gmcastil/6502-sbc/doc/README.md

Schematics here - not necessarily synced with the current board design.
