gmcastil/6502-sbc/doc/schematics/SBC-prototype.pdf

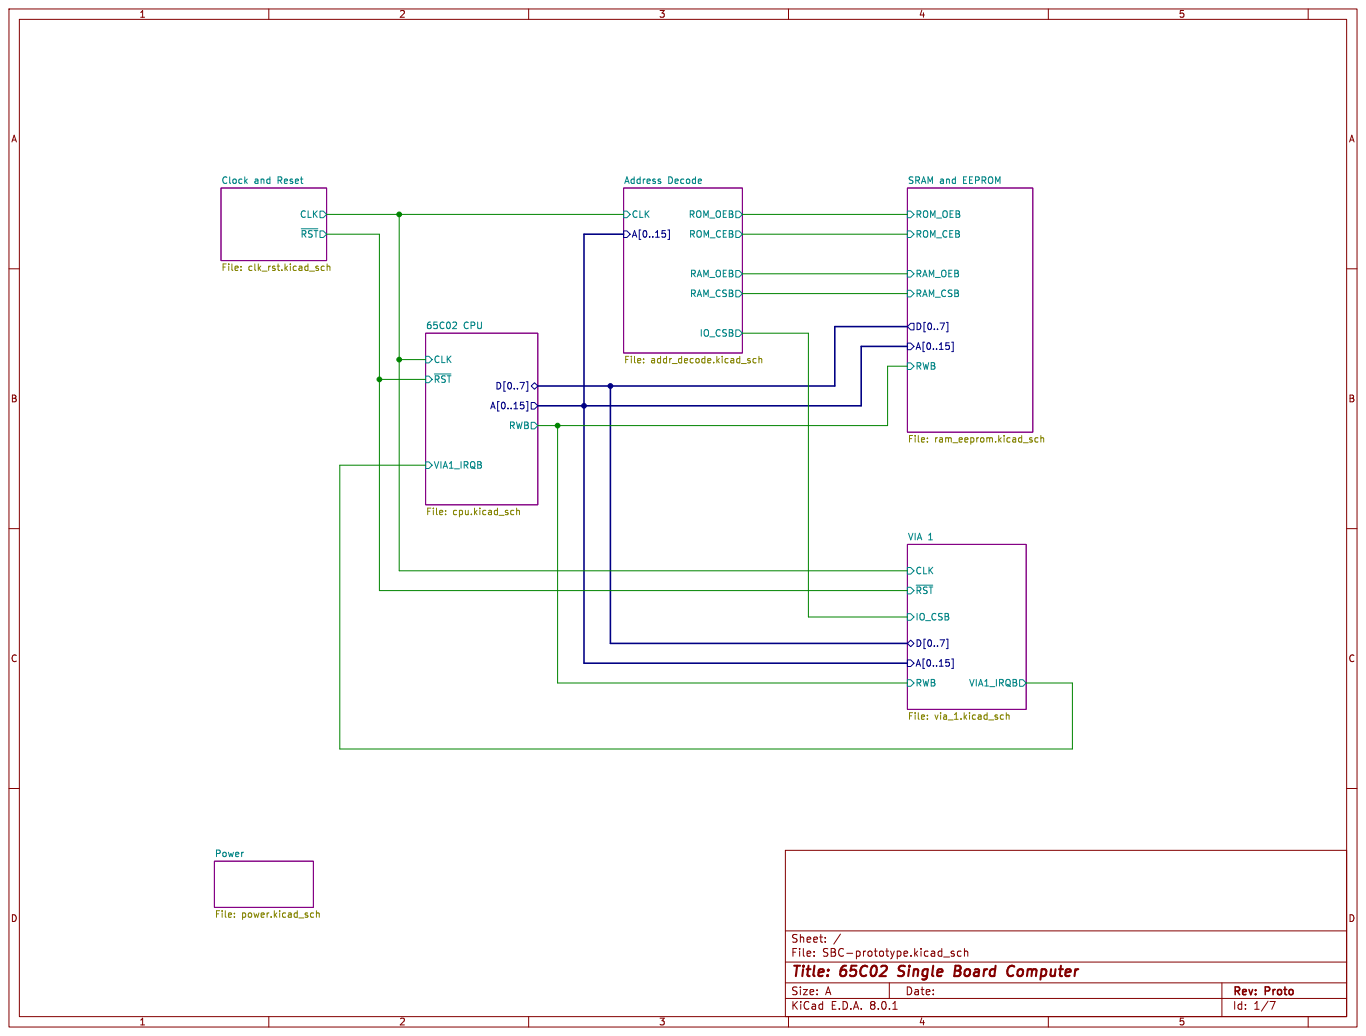
[picture p1: page 1]

~{RST} Clock and Reset File: clk_rst.kicad_sch Power File: power.kicad_sch

Id: 1/7 Title: 65C02 Single Board Computer File: SBC-prototype.kicad_sch Sheet: /

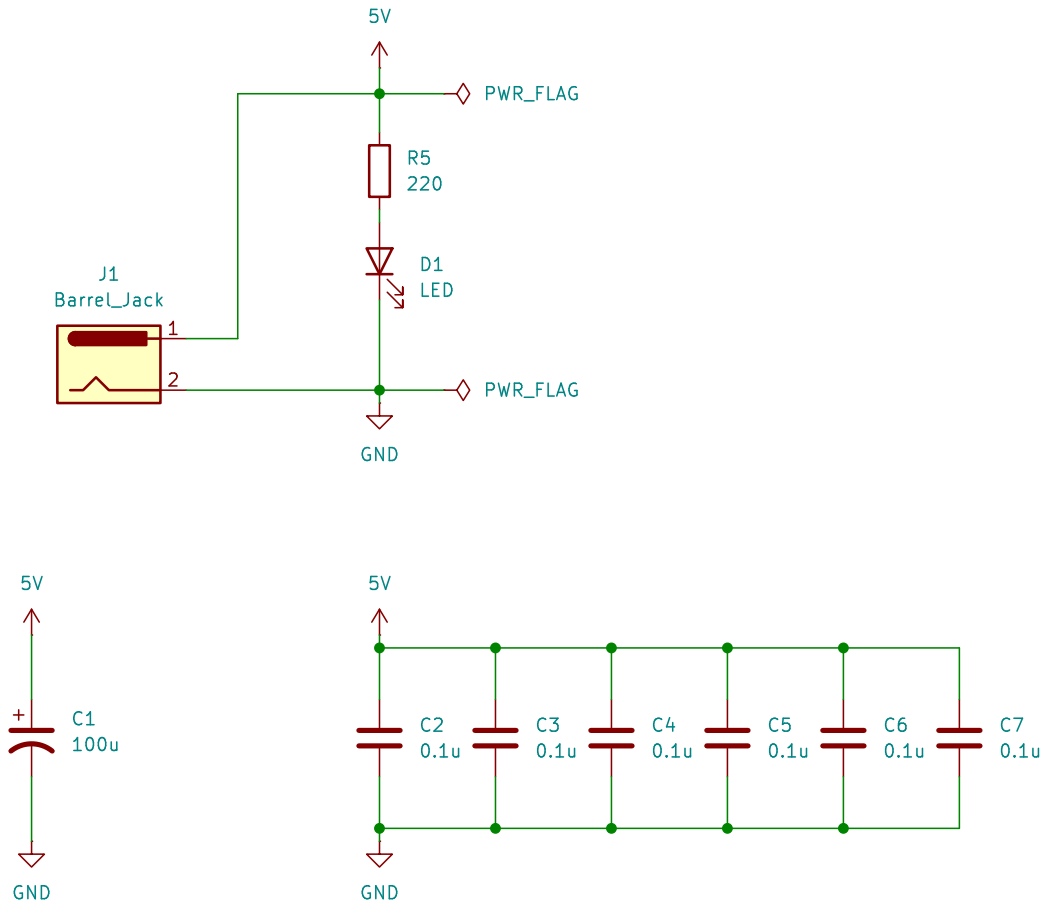
[picture p2: page 2]

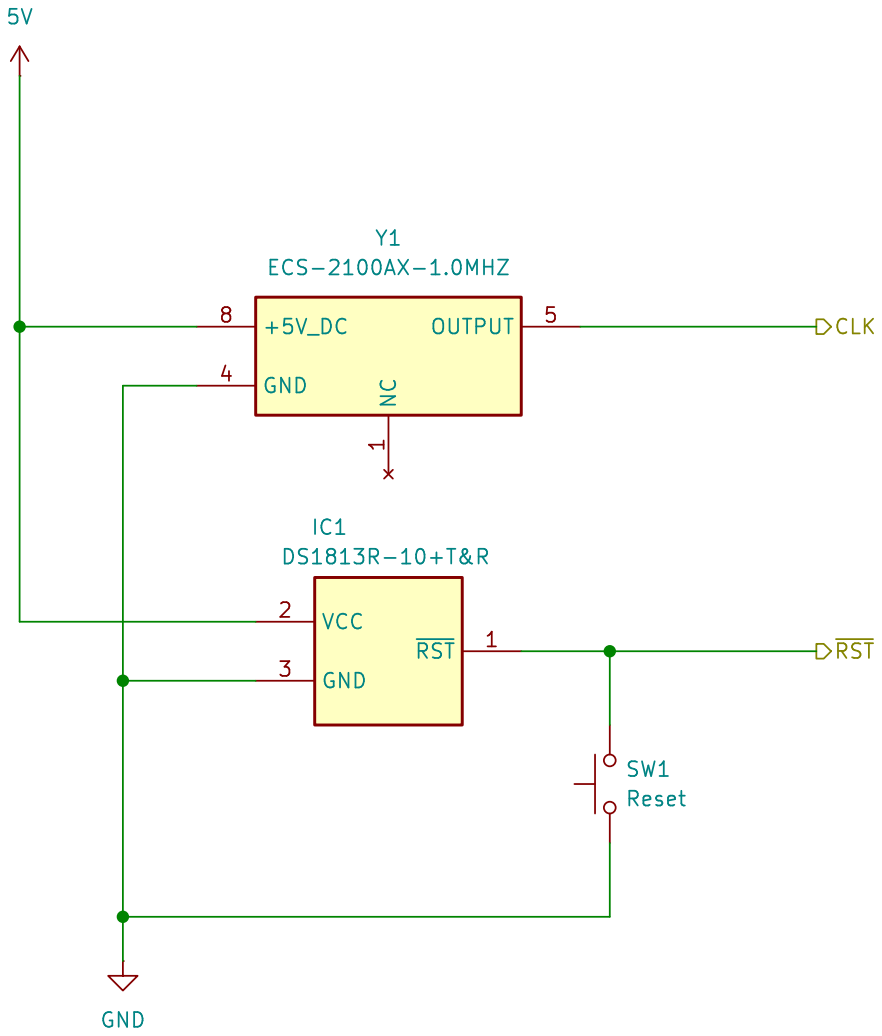
[picture p3: page 3]

1 GND 4 OUTPUT 5 +5V_DC 8 Y1 ECS-2100AX-1.0MHZ CLK

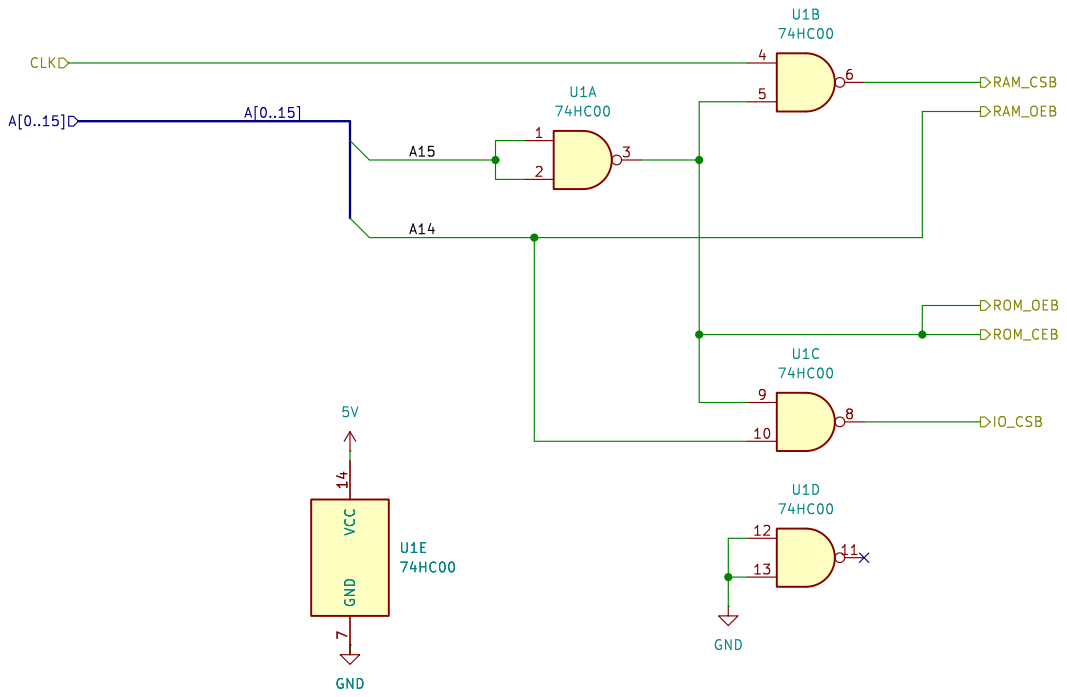
[picture p4: page 4]

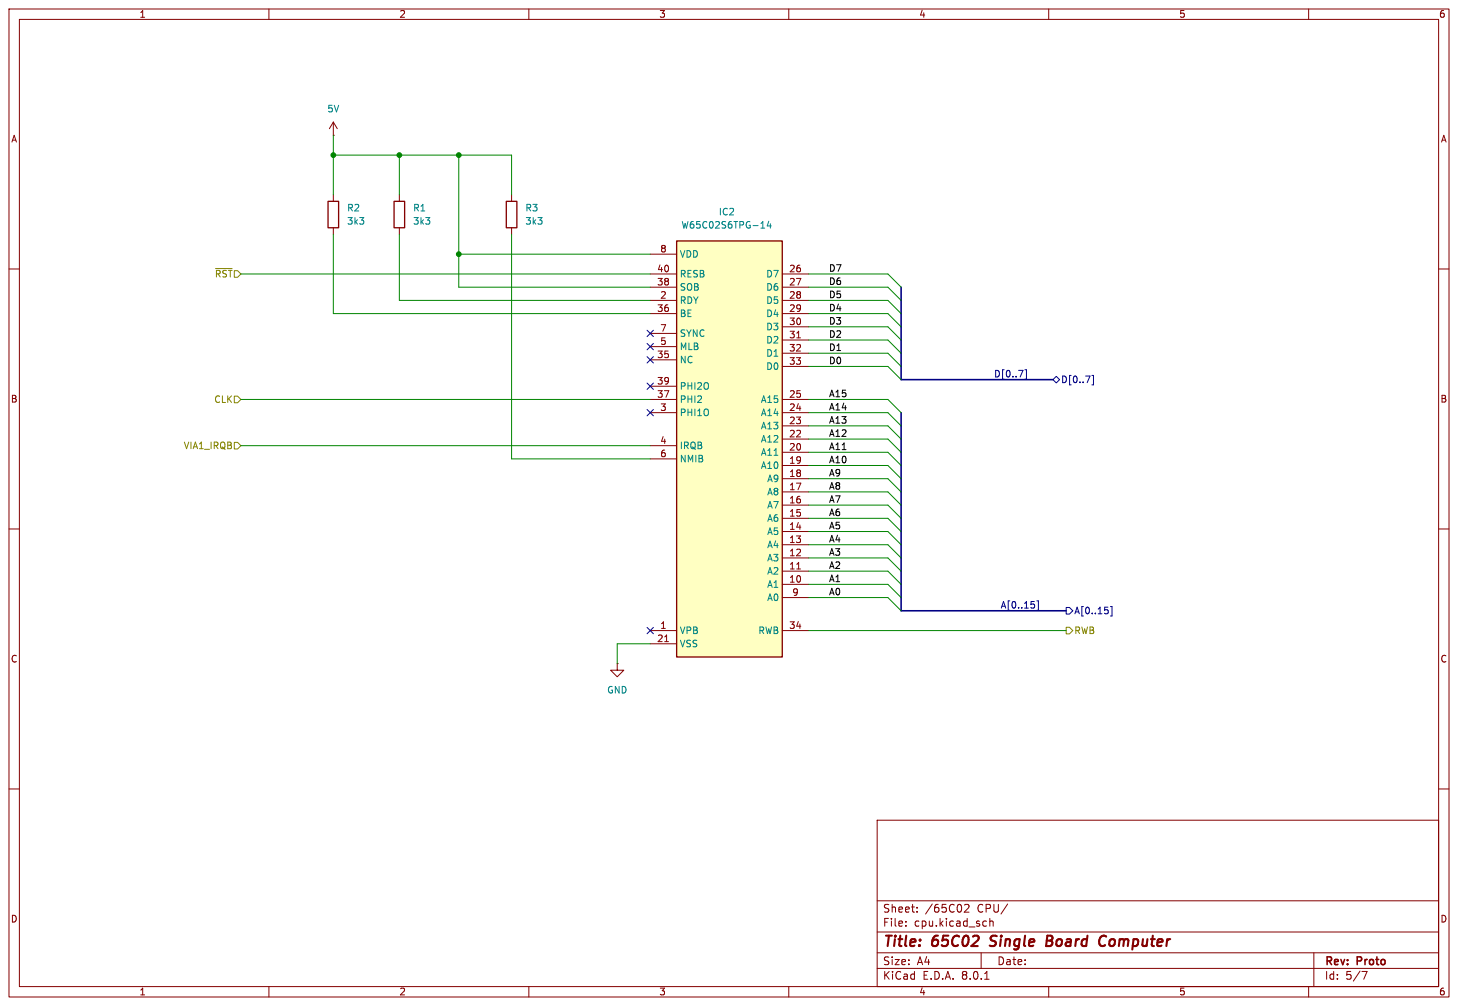
[picture p5: page 5]

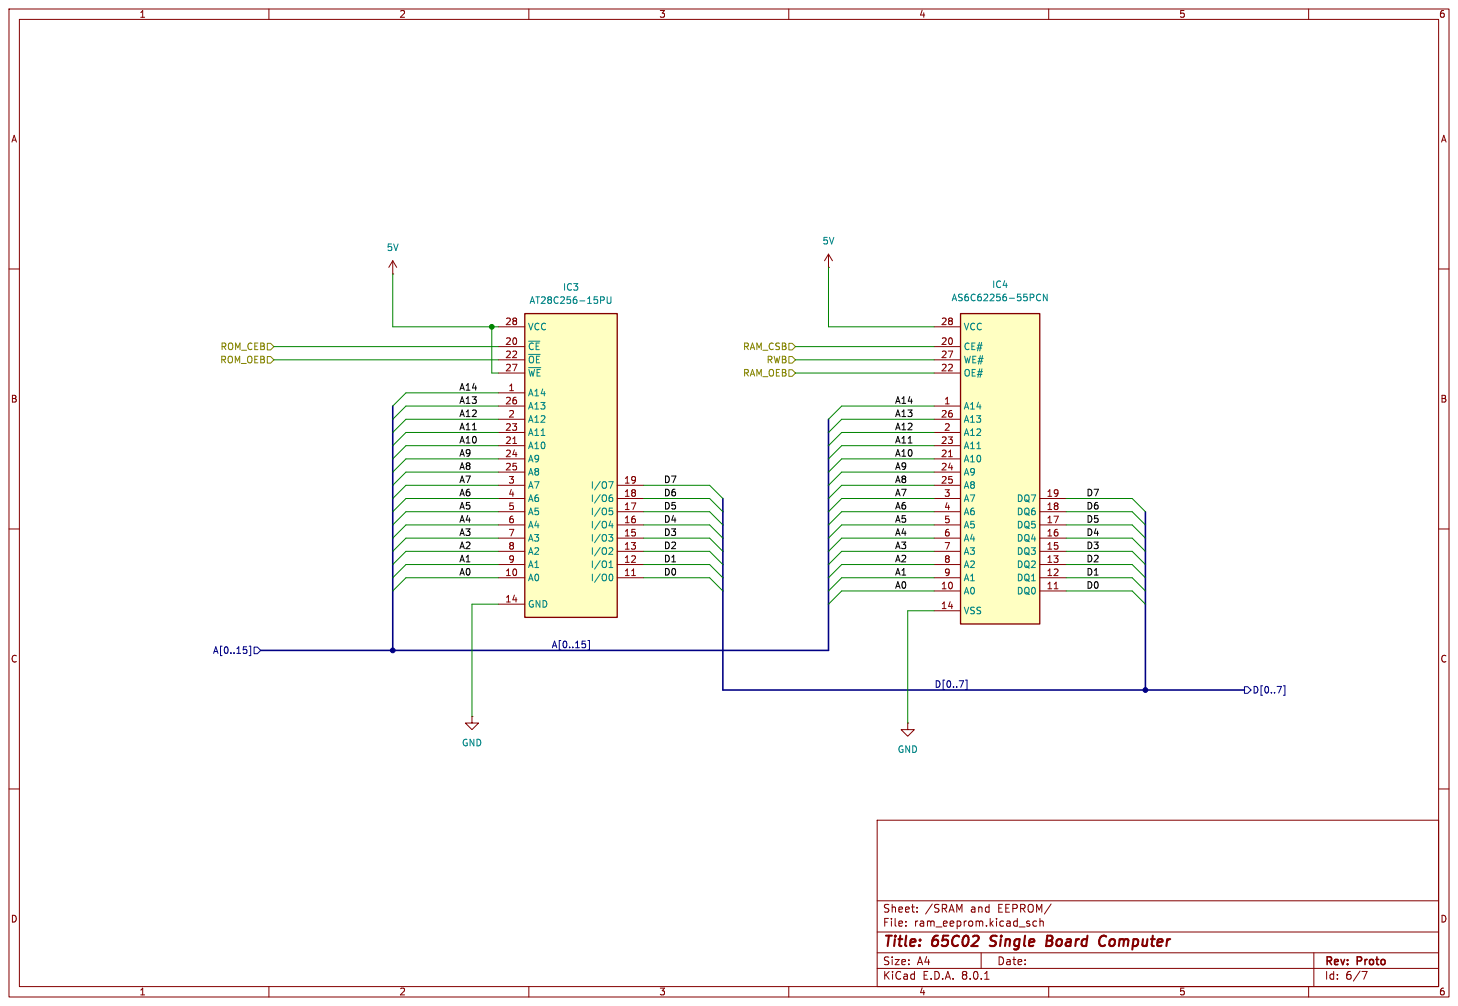
[picture p6: page 6]

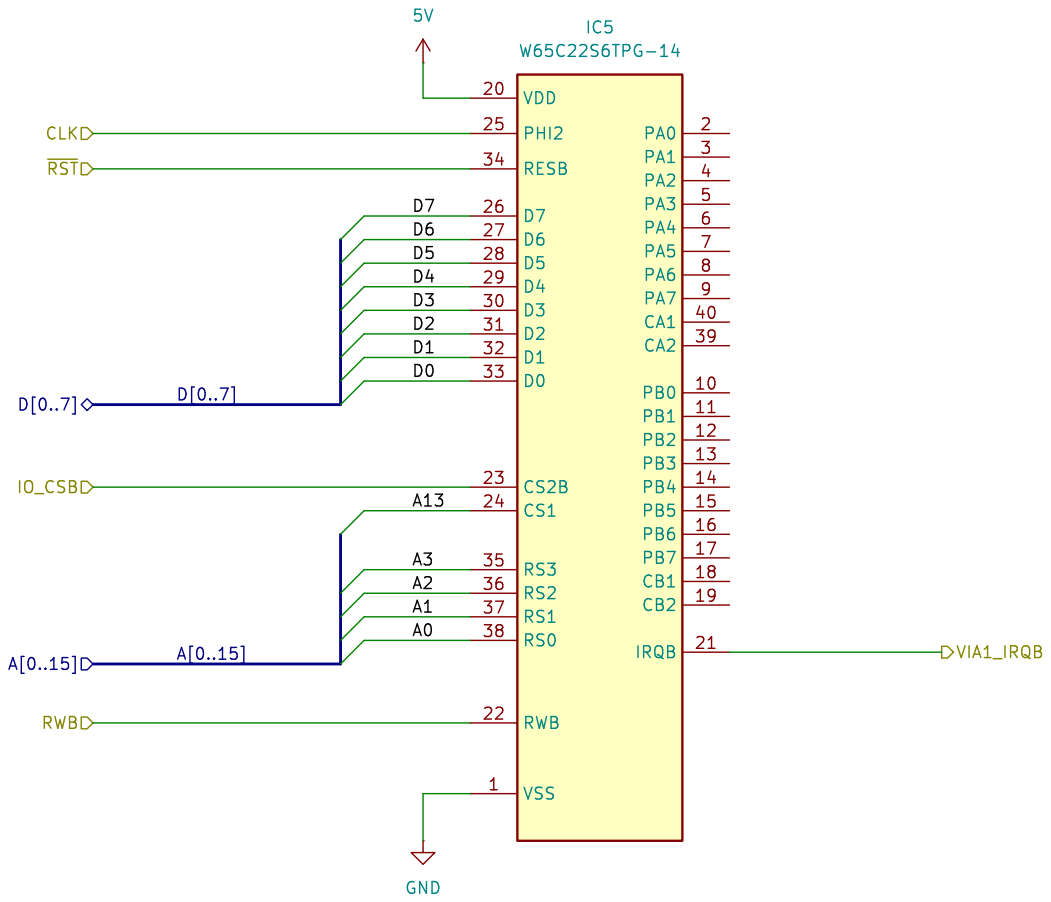
[picture p7: page 7]

Id: 7/7 Title: 65C02 Single Board Computer File: via_1.kicad_sch Sheet: /VIA 1/ GND
