gmcastil/6502-sbc/kicad/SBC-prototype/SBC-prototype.kicad_pcb

## KiCad design kicad/moisture_sensor/moisture_sensor.kicad_sch

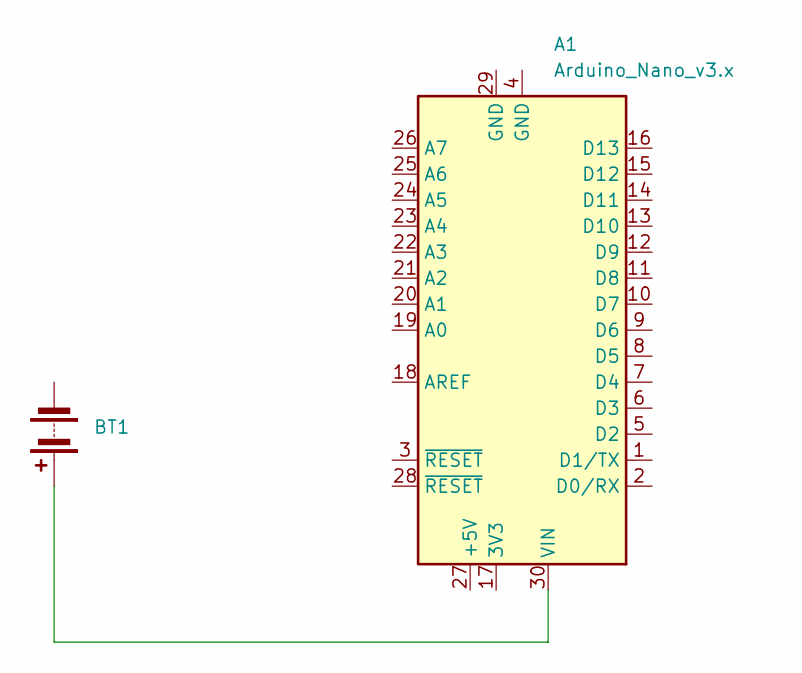
[picture p8: schematic moisture_sensor.kicad_sch]

Parts:
A1: Arduino_Nano_v3.x; Arduino_Nano
BT1: Battery

Connections:
unnamed: A1.30 (VIN), BT1.1 (+)
