gmcastil/6502-sbc/(commit log)

2024-04-28 First step is to debug the existing circuit and draw it up in Kicad
2024-04-29 Adding my first cut at a 6502 monitor
2024-04-29 Thrashing with my Arduino trying to get it to work
2024-04-29 First Kicad 8.0 project for the SBC
    - Just a prototype to start learning the tool
    - Done my Macbook Air - no idea if this will translate over to a Windows
    version of the Kicad tool
    - Need to get this working on the board now.
    [SBC-prototype.kicad_pcb, SBC-prototype.kicad_sch]
2024-05-01 Fixed an issue with MSB and LSB being reversed in the monitor
    [6502-monitor.ino]
2024-05-01 Moved the 6502 monitor sketch so the Arduino IDE can find it.
2024-05-06 Adding power, ground, clocks, reset, and basic address decode logic.
    - Need to specify exactly how the address decode logic is going to work
    - Should decide how many VIA and UART I want on the Mk0 revision
    [SBC-prototype.kicad_sch, addr_decode.kicad_sch, clk_rst.kicad_sch, power.kicad_sch]
2024-05-07 Started on address decode logic. Need to finihs this tonight.
    [SBC-prototype.kicad_sch, addr_decode.kicad_sch, cpu.kicad_sch]
2024-05-08 Stubbed in an ISR to remind myself to add the ability to monitor for reset activity
    [6502-monitor.ino]
2024-05-08 Adding SRAM and EEPROM to schematic
    - Also ignoring all Kicad backup .zip files
    [SBC-prototype.kicad_sch, addr_decode.kicad_sch, clk_rst.kicad_sch, cpu.kicad_sch, power.kicad_sch, ram_eeprom.kicad_sch]
2024-05-09 Added a VIA page to the board schematic
    [via_1.kicad_sch]
2024-05-09 Added a power LED, decoupling caps for the power supply and each IC
    - Power supply now has a 100uF polarized cap on the 5V rail and 0.1uF
    caps on each of the IC power pins.
    - Going to add a VIA to drive an LCD display and then build it
    - Haven't looked at footprints yet
    - Power input needs a SPDT power switch (I like the power switch like
    what is on the Xilinx FPGA eval boards).
    [SBC-prototype.kicad_sch, power.kicad_sch, ram_eeprom.kicad_sch]
2024-05-09 Finished hooking up VIA1 to the processor
    - Wired the VIA IRQ to the processor IRQ line
    - Probably ready to build the Mark 0 on a breadboard at this point
    [cpu.kicad_sch, via_1.kicad_sch]
2024-05-11 Adding a location for the latest schematic
2024-05-11 Adding a basic README to the schematics directory
2024-05-11 Started including hierarchical flow in the top level sheet
    - First, hierarchical designs - I don't need a schematic to all fit on
    one sheet.
    - I had the clock and reset lines as global labels, so I converted them
    to hierarchical labels instead, imported them on each sheet, and then
    connected the sheets together. It probably looks like overkill right
    now, but it will allow me to modify each block more easily
    - The VIA has unconnected ports for now because I haven't wired them to
    anything on the prototyep in the lab yet. That's next, once the
    EEPROM, SRAM, and address decoders are all working (and VIA1 doesn't
    need a load except for maybe some resistors for now).
    - Finally, the p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
    [SBC-prototype.kicad_sch, addr_decode.kicad_sch, clk_rst.kicad_sch, cpu.kicad_sch, power.kicad_sch, ram_eeprom.kicad_sch, via_1.kicad_sch]
2024-05-12 The pull up resistor for the IRQB and NMIB lines should be 3.3k ohms.
    - This might not be accurate - depends on if my interrupt source (the
    65C22) is a n 'S' variant or not, which can pull both up and down.
    - That's going to be an inportant detail when it comes to adding other
    VIA because if it pulls both ways, I'll need to AND the interrupt
    sources together instead of wired-OR'ing them.
    [cpu.kicad_sch]
2024-05-13 Removed pull up resistor on the IRQB line from VIA 1 to the processor. Confirmed 65C22S with totem pole IRQ.
    [cpu.kicad_sch]
2024-05-16 Updated schematic after fixing a bunch of DRC errors and warnings
2024-05-16 Ignoring schematic lock files now
2024-05-16 Fixed a ton of DRC errors and warnings
    - VIA 1 is still unconnected since it's on the breadboard that way and I
    haven't hooked it to anything yet
    - All the parts in the library have changed because I've modified my own
    versions of them. I'm not sure if I should add my changes to the
    library or find a way to tell the tool that it's OK that those are
    updated.
    - The 74HC00 NAND gate was completely broken and would have been an
    interesting problem to sort out during routing and placement
    [SBC-prototype.kicad_sch, addr_decode.kicad_sch, cpu.kicad_sch, power.kicad_sch, ram_eeprom.kicad_sch, via_1.kicad_sch]
